FOSSEE/openplc_v2/README.md

[OpenPLC](https://openplc.fossee.in/) _model 2_ development documentation.

Contact by [mail](mailto:contact-openplc@fossee.in) for details.

> NOTE: the project is a work in progress.
