FOSSEE/openplc_v2/technicalDocument/technicalDocument.odt

OpenPLC Pin mapping

Relays left to right
