FOSSEE/openplc_v2/boardCAD/sketch.dxf

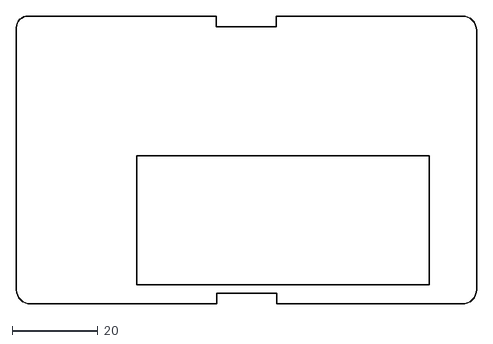
[picture p1: CAD file, 2019-04-26]
boardCAD/sketch.dxf
107.1 x 67.0
