FOSSEE/openplc_v2/(list of files, cad)

Other CAD files:
boardCAD/cutLines.fcstd
boardCAD/newCut.fcstd
boardCAD/newCut.dxf
