FOSSEE/openplc_v2/openPlc_Rpi.kicad_pcb

## KiCad design openPlc_Rpi.kicad_pcb (2020-06-01)

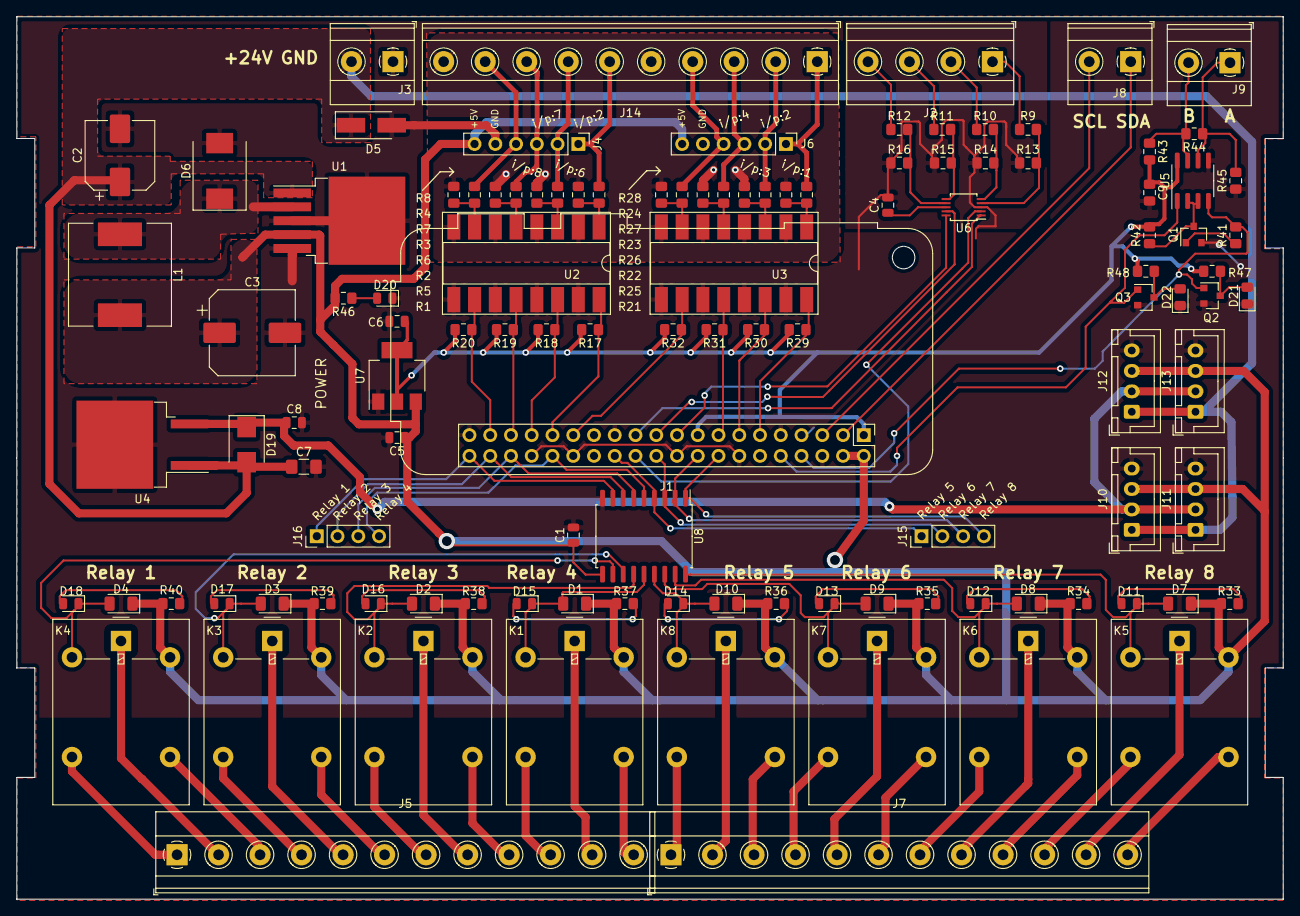
[picture p29: board openPlc_Rpi.kicad_pcb from above]

Board: 2 copper layers, 155.0 x 108.0 mm, 115 parts (0 on the bottom side), 103 nets.

Parts:
C1: 100nf; C_0805_2012Metric
C2: 150uf; CP_Elec_8x10
C3: 1000uf; CP_Elec_10x10
C4: 100n; C_0805_2012Metric
C5, C6: 22uf; C_0805_2012Metric
C7: .33uf; C_1206_3216Metric_Pad1.42x1.75mm_HandSolder
C8: .1uf; C_0805_2012Metric
C9: 1uf; C_0805_2012Metric_Pad1.15x1.40mm_HandSolder
D1, D2, D3, D4, D7, D8, D9, D10: D_Zener; D_1206_3216Metric
D5: NTS245SF; D_SMA_Handsoldering
D6: B340; D_SMC
D11, D12, D13, D14, D15, D16, D17, D18: LED; LED_0805_2012Metric
D19: S1BB; D_SMB
D20: LED_ALT; LED_0805_2012Metric
D21, D22: LED; LED_0805_2012Metric_Pad1.15x1.40mm_HandSolder
J1: Raspberry_Pi_2_3; Raspberry_Pi_Zero_FaceUp_SingleMountingHole
J2: Screw_Terminal_01x04; TerminalBlock_Phoenix_MKDS-1,5-4-5.08_1x04_P5.08mm_Horizont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
J3, J8, J9: Screw_Terminal_01x02; TerminalBlock_Phoenix_MKDS-1,5-2-5.08_1x02_P5.08mm_Horizont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
J4, J6: bergStrip_01x06_Male; bergStrip_male_1x06_P2.54mm_Vertical
J5, J7: Screw_Terminal_01x12; TerminalBlock_Phoenix_MKDS-1,5-12-5.08_1x12_P5.08mm_Horizon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
J10, J11, J12, J13: Conn_01x04; JST_XH_B4B-XH-A_1x04_P2.50mm_Vertical
J14: Screw_Terminal_01x10; TerminalBlock_Phoenix_MKDS-1,5-10-5.08_1x10_P5.08mm_Horizon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
J15, J16: bergStrip_01x04_Male; bergStrip_1x04_P2.54mm_Vertical
K1, K2, K3, K4, K5, K6, K7, K8: G5LE-1; Relay_SPDT_Omron-G5LE-1
L1: 680uh; L_12x12mm_H6mm
Q1: BSS123; SOT-23
Q2, Q3: 2N7002; SOT-23
R1, R2, R3, R4, R5, R6, R7, R8, R9, R10, R11, R12, R17, R18, R19, R20, R21, R22, R23, R24, R25, R26, R27, R28, R29, R30, R31, R32, R41, R42, R43, R45: 10k; R_0805_2012Metric_Pad1.15x1.40mm_HandSolder
R13, R14, R15, R16: 5k; R_0805_2012Metric_Pad1.15x1.40mm_HandSolder
R33, R34, R35, R36, R37, R38, R39, R40: 220R; R_0805_2012Metric_Pad1.15x1.40mm_HandSolder
R44: 120R; R_0805_2012Metric_Pad1.15x1.40mm_HandSolder
R46: 220; R_0805_2012Metric_Pad1.15x1.40mm_HandSolder
R47, R48: 510R; R_0805_2012Metric_Pad1.15x1.40mm_HandSolder
U1: power_LM2576; TO-263-5_TabPin3
U2, U3: LTV-847; DIP-16_W8.89mm_SMDSocket_LongPads
U4: power_L7812_smd; TO-263-2
U5: MAX481E; SOIC-8_3.9x4.9mm_P1.27mm
U6: ADS1018IDGS; TSSOP-10_3x3mm_P0.5mm
U7: AMS1117-3.3; SOT-223-3_TabPin2
U8: ULN2803A; SOIC-18W_7.5x11.6mm_P1.27mm

Connections:
+3V3: C6.1, C9.1, J1.1, J1.17, R17.2, R18.2, R19.2, R20.2, R29.2, R30.2, R31.2, R32.2, R42.2, R43.2, R47.1, R48.1, U5.8, U7.2
+5V: C1.1, C3.1, C5.1, D1.1, D2.1, D3.1, D4.1, D7.1, D8.1, D9.1, D10.1, J1.2, J1.4, J4.6, J6.6, J10.3, J11.3, J12.3, J13.3, K1.5, K2.5, K3.5, K4.5, K5.5, K6.5, K7.5, K8.5, L1.2, R33.2, R34.2, R35.2, R36.2, R37.2, R38.2, R39.2, R40.1, R46.2, U1.4, U7.3, U8.10
+12V: C8.1, D19.1, J10.2, J11.2, J12.2, J13.2, U4.3
+24V: C2.1, C7.1, D5.1, D19.2, J3.2, J10.1, J11.1, J12.1, J13.1, U1.1, U4.1
/1: J5.10, K1.3
/2: J5.11, K1.1
/3: J5.12, K1.4
/4: J5.7, K2.3
/5: J5.8, K2.1
/6: J5.9, K2.4
/7: J5.4, K3.3
/8: J5.5, K3.1
/9: J5.6, K3.4
/10: J5.1, K4.3
/11: J5.2, K4.1
/12: J5.3, K4.4
/13: J7.10, K5.3
/14: J7.11, K5.1
/15: J7.12, K5.4
/16: J7.7, K6.3
/17: J7.8, K6.1
/18: J7.9, K6.4
/19: J7.4, K7.3
/20: J7.5, K7.1
/21: J7.6, K7.4
/22: J7.1, K8.3
/23: J7.2, K8.1
/24: J7.3, K8.4
/A: J9.1, R44.1, R45.2, U5.6
/B: J9.2, R43.1, R44.2, U5.7
/DIGND: J14.5, J14.10, R5.1, R6.1, R7.1, R8.1, R25.1, R26.1, R27.1, R28.1, U2.2, U2.4, U2.6, U2.8, U3.2, U3.4, U3.6, U3.8
/RXD: J1.10, Q3.1, U5.1
/TXD: J1.8, Q2.1, R41.2, U5.4
CS0: J1.24, U6.2
DI_0: J1.37, R20.1, U2.10
DI_1: J1.35, R19.1, U2.12
DI_2: J1.33, R18.1, U2.14
DI_3: J1.31, R17.1, U2.16
DI_4: J1.29, R32.1, U3.10
DI_5: J1.15, R31.1, U3.12
DI_6: J1.13, R30.1, U3.14
DI_7: J1.11, R29.1, U3.16
DO_0: J1.40, J16.1, U8.8
DO_1: J1.38, J16.2, U8.7
DO_2: J1.36, J16.3, U8.6
DO_3: J1.32, J16.4, U8.5
DO_4: J1.26, J15.1, U8.4
DO_5: J1.22, J15.2, U8.3
DO_6: J1.18, J15.3, U8.2
DO_7: J1.16, J15.4, U8.1
GND: C1.2, C2.2, C3.2, C4.2, C5.2, C6.2, C7.2, C8.2, C9.2, D5.2, D6.2, D20.1, D21.1, D22.1, J1.6, J1.9, J1.14, J1.20, J1.25, J1.30, J1.34, J1.39, J3.1, J4.5, J6.5, J10.4, J11.4, J12.4, J13.4, Q1.2, Q2.2, Q3.2, R13.1, R14.1, R15.1, R16.1, R45.1, U1.3, U1.5, U2.9, U2.11, U2.13, U2.15, U3.9, U3.11, U3.13, U3.15, U4.2, U5.5, U6.3, U7.1, U8.9
MISO: J1.21, U6.9
MOSI: J1.19, U6.10
unnamed: C4.1, U6.8
unnamed: D1.2, D15.1, K1.2, U8.14
unnamed: D6.1, L1.1, U1.2
unnamed: D10.2, D14.1, K8.2, U8.15
unnamed: D7.2, D11.1, K5.2, U8.18
unnamed: D11.2, R33.1
unnamed: D8.2, D12.1, K6.2, U8.17
unnamed: D12.2, R34.1
unnamed: D9.2, D13.1, K7.2, U8.16
unnamed: D13.2, R35.1
unnamed: D14.2, R36.1
unnamed: D15.2, R37.1
unnamed: D2.2, D16.1, K2.2, U8.13
unnamed: D16.2, R38.1
unnamed: D3.2, D17.1, K3.2, U8.12
unnamed: D17.2, R39.1
unnamed: D4.2, D18.1, K4.2, U8.11
unnamed: D18.2, R40.2
unnamed: D20.2, R46.1
unnamed: D21.2, Q2.3, R47.2
unnamed: D22.2, Q3.3, R48.2
unnamed: J2.1, R9.1
unnamed: J2.2, R10.1
unnamed: J2.3, R11.1
unnamed: J2.4, R12.1
unnamed: Q1.1, R41.1
unnamed: Q1.3, R42.1, U5.2, U5.3
unnamed: R1.2, R5.2, U2.1
unnamed: R2.2, R6.2, U2.3
unnamed: R3.2, R7.2, U2.5
unnamed: R4.2, R8.2, U2.7
unnamed: R10.2, R14.2, U6.5
unnamed: R11.2, R15.2, U6.6
unnamed: R12.2, R16.2, U6.7
unnamed: R9.2, R13.2, U6.4
unnamed: R21.2, R25.2, U3.1
unnamed: R22.2, R26.2, U3.3
unnamed: R23.2, R27.2, U3.5
unnamed: R24.2, R28.2, U3.7
SCK: J1.23, U6.1
SCL: J1.5, J8.2
SDA: J1.3, J8.1
in_1: J6.1, J14.1, R21.1
in_2: J6.2, J14.2, R22.1
in_3: J6.3, J14.3, R23.1
in_4: J6.4, J14.4, R24.1
in_5: J4.1, J14.6, R1.1
in_6: J4.2, J14.7, R2.1
in_7: J4.3, J14.8, R3.1
in_8: J4.4, J14.9, R4.1
