FOSSEE/openplc_v2/(commit log)

2019-04-26 April 26th 2019
    [cutLines.fcstd, newCut.dxf, newCut.fcstd, openPlc_Rpi.kicad_pcb, openPlc_Rpi.sch, sketch.dxf]
2019-12-30 [vishnu] unknown
    [components.ods, cutLines.fcstd, newCut.dxf, newCut.fcstd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]
2019-12-30 [vishnu] trial commit in branch working
    [openPlc_Rpi.sch]
2020-01-06 fixed untracked files
    [openPlc_Rpi.sch]
2020-01-21 [vishnu] - remapped the pins for the correct/new orintation of RPi - added the new mapping in the technical document
    [openPlc_Rpi.sch, pinOut.ods]
2020-01-21 [vishnu] - removed the test circuit from the scematic
    [openPlc_Rpi.sch]
2020-01-21 [vishnu] Corrected all footpronts to the present library version; PCB not updated.
    [openPlc_Rpi.kicad_pcb, openPlc_Rpi.sch]
2020-01-30 [vishnu] created new standalone library for the project with all the necessary components and corresponding footprints.
    [openPlc_Rpi.kicad_pcb, openPlc_Rpi.sch]
2020-01-31 [vishnu] Udated library - added LED 0805 symbol and footprint - removed aliases from library leaving just the required components
2020-01-31 [vishnu] replaced Rpi symbol and footprint in schematic and pcb from the new library
    [openPlc_Rpi.kicad_pcb, openPlc_Rpi.sch]
2020-02-01 [vishnu] replaced ADC circuit with new library components : scehmatic and PCB updated
    [openPlc_Rpi.kicad_pcb, openPlc_Rpi.sch]
2020-02-03 [vishnu] Replaced all component in the POWER circuitry with local library components. Added tantalum, C_1206, AMS117 and ls812 parts to the library.
    [openPlc_Rpi.kicad_pcb, openPlc_Rpi.sch]
2020-02-03 [vishnu] Replaced all components in the OUTPUT circuit with local library "fossee_openplc" parts. Deleted an outdated folder with SVG of the older version of the PCB.
    [openPlc_Rpi.kicad_pcb, openPlc_Rpi.sch]
2020-02-03 [vishnu] Replaced INPUT circuit with "fossee_openplc" components. Added *-bak and *.bash to gitignore.
    [openPlc_Rpi.sch]
2020-03-05 [easwaran] rough draft of routing for new orientation completed with no unconnected ratnests.
    [openPlc_Rpi.kicad_pcb, openPlc_Rpi.sch]
2020-03-05 [vishnu] removed tracking of /bom folder. Have reset the cache for the same.
    [components.ods]
2020-05-27 [vishnu] - removed copper pours around relay input for better AC isolation. - did DRC and connected the missing labels of digital inputs.
    [openPlc_Rpi.kicad_pcb, openPlc_Rpi.sch]
2020-05-27 [vishnu] reordered i/p resistors. Added berg strips to local library.
    [openPlc_Rpi.kicad_pcb]
2020-05-29 [vishnu] added rpi 3d step models. moved opto and added the headers. updated the netlist.
    [0204 - Capacitor Brown.SLDPRT, 0204 - Capacitor.SLDPRT, 0204- Resistor.SLDPRT, 0805- Capacitor.SLDPRT, 1210 inductor.SLDPRT, 32,768 Khz Crystal.SLDPRT, 6-Pin SOT.SLDPRT, CAP-0306.SLDPRT]
2020-05-29 [vishnu] removed evrything except step file of rpi.
    [0204 - Capacitor Brown.SLDPRT, 0204 - Capacitor.SLDPRT, 0204- Resistor.SLDPRT, 0805- Capacitor.SLDPRT, 1210 inductor.SLDPRT, 32,768 Khz Crystal.SLDPRT, 6-Pin SOT.SLDPRT, CAP-0306.SLDPRT]
2020-06-01 [vishnu] Added male headers at input and output. PCB updated. Labels updated.
    [openPlc_Rpi.kicad_pcb, openPlc_Rpi.sch]
